mildlyfunctionalgays/bigbutton/board/bigbutton/bigbutton.kicad_pcb

## KiCad design board/bigbutton/bigbutton.kicad_pcb (2021-04-25)

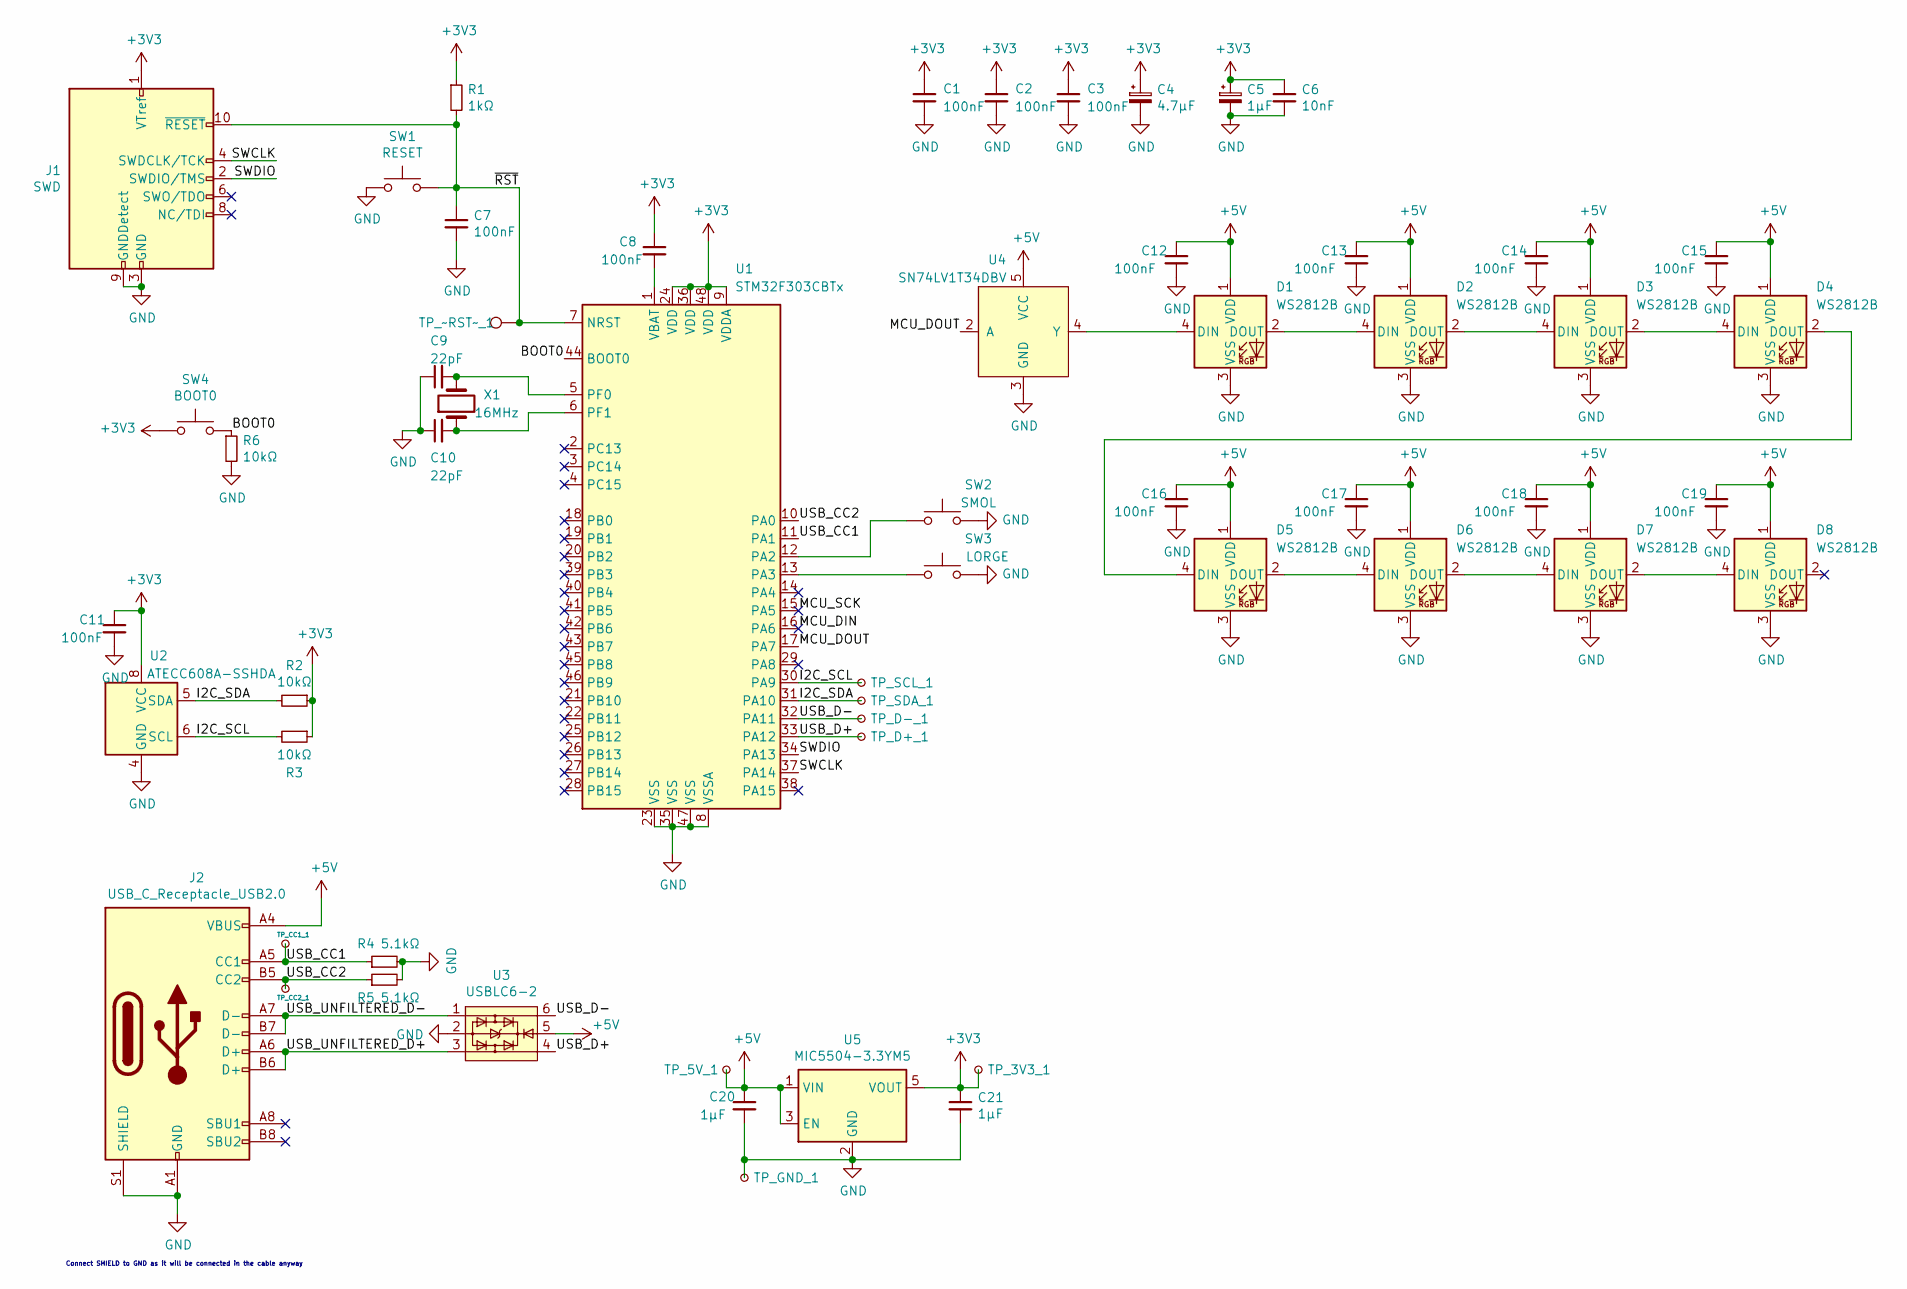
[picture p1: schematic bigbutton.kicad_sch, Big Button]

Parts:
C1, C2, C3, C7, C8, C11, C12, C13, C14, C15, C16, C17, C18, C19: 100nF; C_0603_1608Metric
C4: 4.7µF; C_0603_1608Metric
C5, C20, C21: 1µF; C_0603_1608Metric
C6: 10nF; C_0603_1608Metric
C9, C10: 22pF; C_0603_1608Metric
D1, D2, D3, D4, D5, D6, D7, D8: WS2812B; LED_WS2812B_PLCC4_5.0x5.0mm_P3.2mm
J1: SWD; PinHeader_2x05_P1.27mm_Vertical
J2: USB_C_Receptacle_USB2.0; USB_C_Receptacle_JING_C167321_HandSolder
R1: 1kΩ; R_0603_1608Metric
R2, R3, R6: 10kΩ; R_0603_1608Metric
R4, R5: 5.1kΩ; R_0603_1608Metric
SW1: RESET; SW_SPST_XKB_TS-1187A
SW2: SMOL; SW_Cherry_MX_1.00u_PCB
SW3: LORGE; SW_BIG_SWITCH
SW4: BOOT0; SW_SPST_XKB_TS-1187A
TP_3V3_1, TP_5V_1: TestPoint_Small; TestPoint_Pad_D1.0mm
TP_CC1_1: TP_CC1; TestPoint_Pad_D1.0mm
TP_CC2_1: TP_CC2; TestPoint_Pad_D1.0mm
TP_D+_1: TestPoint_Small; TestPoint_Pad_D1.0mm
TP_D-_1: TestPoint_Small; TestPoint_Pad_D1.0mm
TP_GND_1: TestPoint_Small; TestPoint_Pad_D1.0mm
TP_SCL_1: TestPoint_Small; TestPoint_Pad_D1.0mm
TP_SDA_1: TestPoint_Small; TestPoint_Pad_D1.0mm
TP_~RST~_1: TestPoint; TestPoint_Pad_D1.0mm
U1: STM32F303CBTx; LQFP-48_7x7mm_P0.5mm
U2: ATECC608A-SSHDA; SOIC-8_3.9x4.9mm_P1.27mm
U3: USBLC6-2; SOT-23-6_Handsoldering
U4: SN74LV1T34DBV; SOT-23-5_HandSoldering
U5: MIC5504-3.3YM5; SOT-23-5_HandSoldering
X1: 16MHz; Resonator-2Pin_W10.0mm_H5.0mm

Connections:
+3V3: C1.1, C2.1, C3.1, C4.1, C5.1, C6.1, C8.1, C11.1, C21.1, J1.1 (VTref), R1.1, R2.1, R3.1, SW4.1, TP_3V3_1.1, U1.9 (VDDA), U1.24 (VDD), U1.36 (VDD), U1.48 (VDD), U2.8 (VCC), U5.5 (VOUT)
+5V: C12.1, C13.1, C14.1, C15.1, C16.1, C17.1, C18.1, C19.1, C20.1, D1.1 (VDD), D2.1 (VDD), D3.1 (VDD), D4.1 (VDD), D5.1 (VDD), D6.1 (VDD), D7.1 (VDD), D8.1 (VDD), J2.A4 (VBUS), J2.A9 (VBUS), J2.B4 (VBUS), J2.B9 (VBUS), TP_5V_1.1, U3.5, U4.5 (VCC), U5.1 (VIN), U5.3 (EN)
/BOOT0: R6.1, SW4.2, U1.44 (BOOT0)
/I2C_SCL: R3.2, TP_SCL_1.1, U1.30 (PA9), U2.6 (SCL)
/I2C_SDA: R2.2, TP_SDA_1.1, U1.31 (PA10), U2.5 (SDA)
/MCU_DIN: U1.16 (PA6)
/MCU_DOUT: U1.17 (PA7), U4.2 (A)
/MCU_SCK: U1.15 (PA5)
/SWCLK: J1.4 (SWDCLK/TCK), U1.37 (PA14)
/SWDIO: J1.2 (SWDIO/TMS), U1.34 (PA13)
/USB_CC1: J2.A5 (CC1), R4.1, TP_CC1_1.1, U1.11 (PA1)
/USB_CC2: J2.B5 (CC2), R5.1, TP_CC2_1.1, U1.10 (PA0)
/USB_D+: TP_D+_1.1, U1.33 (PA12), U3.4
/USB_D-: TP_D-_1.1, U1.32 (PA11), U3.6
/USB_UNFILTERED_D+: J2.A6 (D+), J2.B6 (D+), U3.3
/USB_UNFILTERED_D-: J2.A7 (D-), J2.B7 (D-), U3.1
/~RST: C7.1, J1.10 (~RESET~), R1.2, SW1.2, TP_~RST~_1.1, U1.7 (NRST)
GND: C1.2, C2.2, C3.2, C4.2, C5.2, C6.2, C7.2, C9.1, C10.1, C11.2, C12.2, C13.2, C14.2, C15.2, C16.2, C17.2, C18.2, C19.2, C20.2, C21.2, D1.3 (VSS), D2.3 (VSS), D3.3 (VSS), D4.3 (VSS), D5.3 (VSS), D6.3 (VSS), D7.3 (VSS), D8.3 (VSS), J1.3 (GND), J1.5 (GND), J1.9 (GNDDetect), J2.A1 (GND), J2.A12 (GND), J2.B1 (GND), J2.B12 (GND), J2.S1 (SHIELD), R4.2, R5.2, R6.2, SW1.1, SW2.2, SW3.2, TP_GND_1.1, U1.8 (VSSA), U1.23 (VSS), U1.35 (VSS), U1.47 (VSS), U2.4 (GND), U3.2, U4.3 (GND), U5.2 (GND)
unnamed: C8.2, U1.1 (VBAT)
unnamed: C9.2, U1.5 (PF0), X1.2
unnamed: C10.2, U1.6 (PF1), X1.1
unnamed: D1.2 (DOUT), D2.4 (DIN)
unnamed: D1.4 (DIN), U4.4 (Y)
unnamed: D2.2 (DOUT), D3.4 (DIN)
unnamed: D3.2 (DOUT), D4.4 (DIN)
unnamed: D4.2 (DOUT), D5.4 (DIN)
unnamed: D5.2 (DOUT), D6.4 (DIN)
unnamed: D6.2 (DOUT), D7.4 (DIN)
unnamed: D7.2 (DOUT), D8.4 (DIN)
unnamed: SW2.1, U1.12 (PA2)
unnamed: SW3.1, U1.13 (PA3)

Notes on the sheet:
Connect SHIELD to GND as it will be connected in the cable anyway

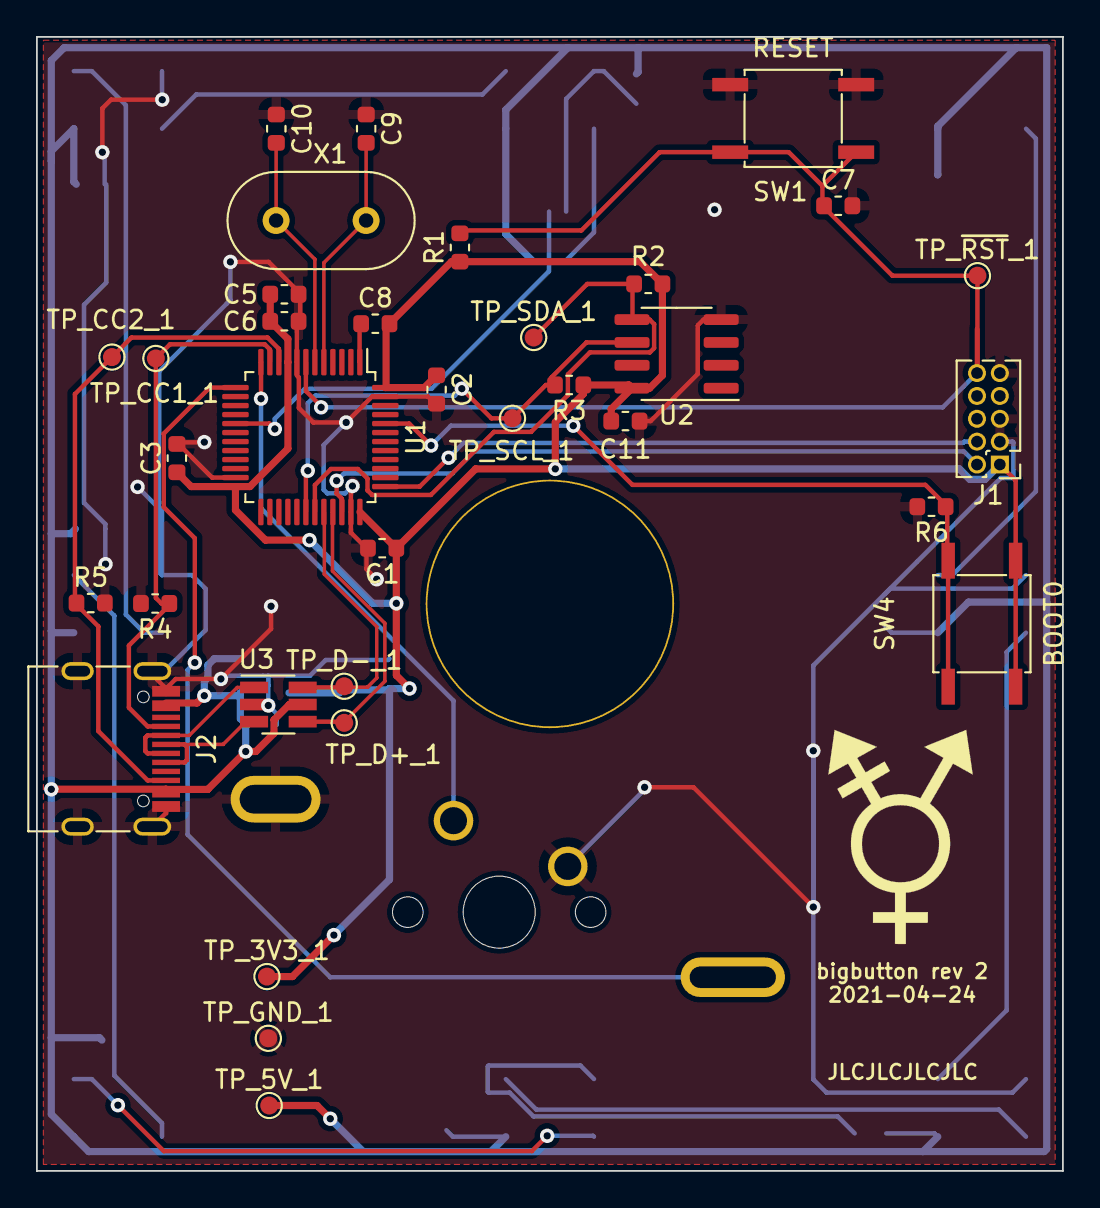
[picture p2: board bigbutton.kicad_pcb from above]

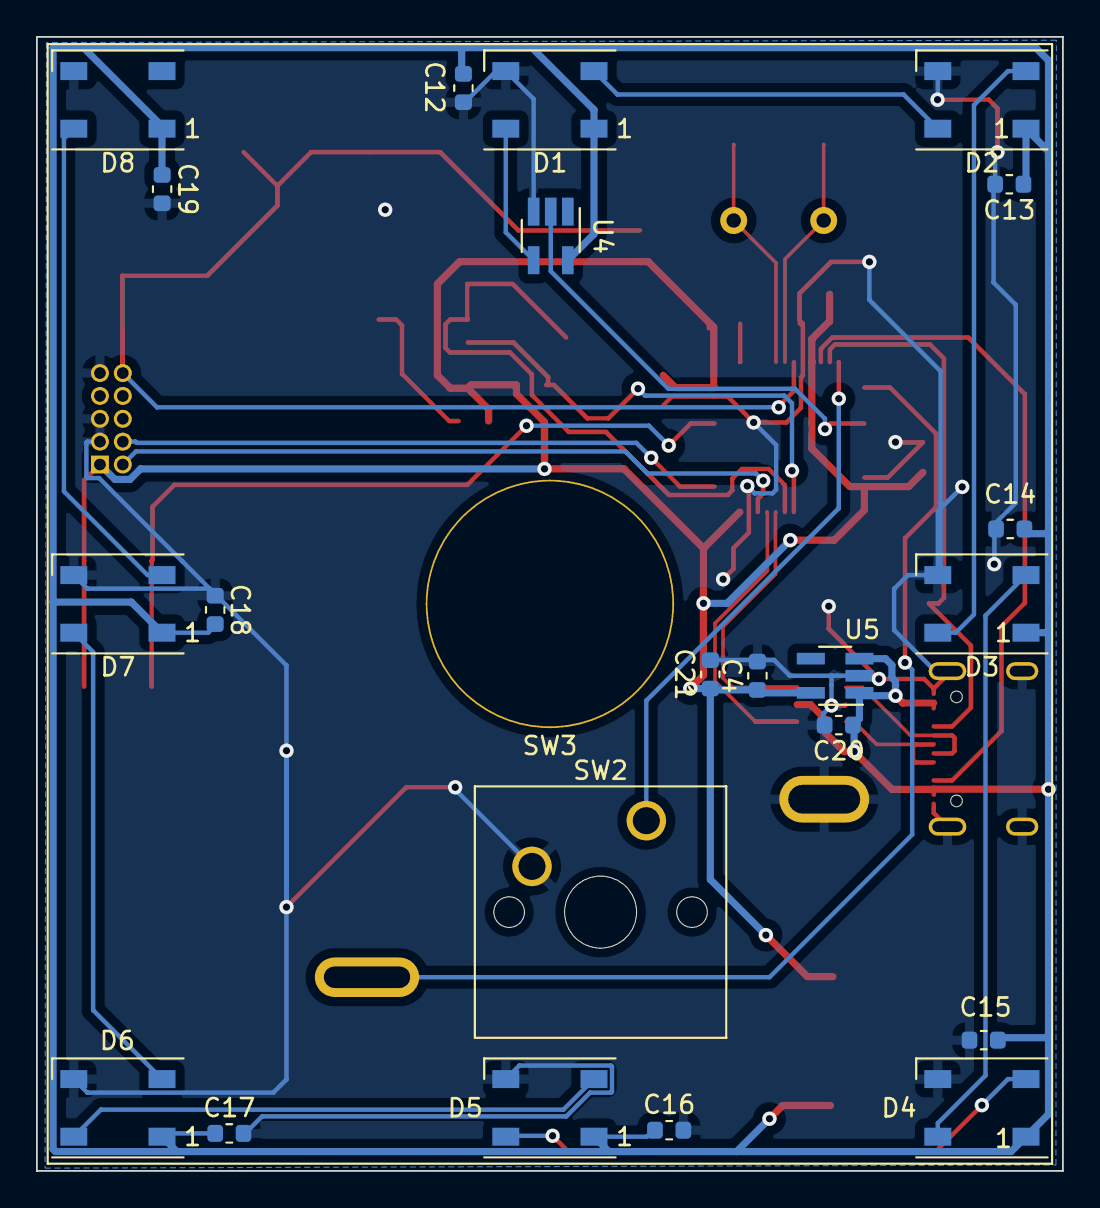
[picture p3: board bigbutton.kicad_pcb from below]

Board: 2 copper layers, 57.0 x 63.0 mm, 58 parts (23 on the bottom side), 29 nets.

Other parts of the board:
G0: LOGO; trans
