mildlyfunctionalgays/bigbutton/(commit log)

2020-09-14 Start PCB
    [bigbutton.kicad_pcb, bigbutton.sch]
2020-09-15 Start moving to STM32
    [bigbutton.sch]
2020-09-16 Add LEDs and create a symbol for level shifter
    [bigbutton.sch]
2020-09-16 Add vreg
    [bigbutton.sch]
2020-09-25 Start PCB routing
    [bigbutton.kicad_pcb, bigbutton.sch]
2020-09-25 Done with first routing attempt
    [bigbutton.kicad_pcb, bigbutton.sch]
2020-09-26 Lots of rerouting
    [bigbutton.kicad_pcb]
2020-09-26 Further rerouting
    [bigbutton.kicad_pcb]
2020-09-26 Add BOOT0 button
    [bigbutton.kicad_pcb, bigbutton.sch]
2020-09-26 Clean up silkscreen
    [bigbutton.kicad_pcb]
2020-09-26 Send for production (rev. 1)
    [bigbutton-B_Cu.gbr, bigbutton-B_Mask.gbr, bigbutton-B_SilkS.gbr, bigbutton-Edge_Cuts.gbr, bigbutton-F_Cu.gbr, bigbutton-F_Mask.gbr, bigbutton-F_SilkS.gbr, bigbutton-NPTH.drl]
2020-09-27 Switch to pin-compatible STM32F303CBT6, as reflected in order
    [bigbutton.kicad_pcb, bigbutton.sch]
2020-10-10 Switch to a top-mount USB connector from an incorrect mid-mount
    [bigbutton.kicad_pcb, bigbutton.sch]
2020-10-10 Adjust board, add trans symbol to silkscreen
    [bigbutton.kicad_pcb]
2020-10-18 Update footprint for bigbutton
    [bigbutton.kicad_pcb]
2021-04-24 Hopefully revision 2
    [bigbutton.kicad_pcb, bigbutton.kicad_sch, bigbutton.sch]
2021-04-25 Add gerbers
    [bigbutton-B_Cu.gbr, bigbutton-B_Mask.gbr, bigbutton-B_SilkS.gbr, bigbutton-B_Silkscreen.gbr, bigbutton-Edge_Cuts.gbr, bigbutton-F_Cu.gbr, bigbutton-F_Mask.gbr, bigbutton-F_SilkS.gbr]
2021-04-25 Migrate to new library format
    [bigbutton.sch]
2021-04-26 Add SK6812 Mini E symbol and footprint
